HongjunWu-up/HongjunWu-up-BallAndPlate-ControlSystem/Ball_Board/Ball_Board/Ball_Board.ioc

Mcu.UserName=STM32F103C8Tx
PA11.Signal=S_TIM1_CH4
PA13.Signal=SYS_JTMS-SWDIO
PA14.Signal=SYS_JTCK-SWCLK
PA4.GPIO_Label=LED1
PA4.Signal=GPIO_Output
PA8.Signal=S_TIM1_CH1
PB10.Signal=USART3_TX
PB11.Signal=USART3_RX
PB6.Signal=USART1_TX
PB7.Signal=USART1_RX
PD0-OSC_IN.Signal=RCC_OSC_IN
PD1-OSC_OUT.Signal=RCC_OSC_OUT
